MarwanGoat/DIY-3D-PRINTER-/schematics and blueprints/6 - BTT SKR Controller + FSYTEC 12864 RGB LCD.png

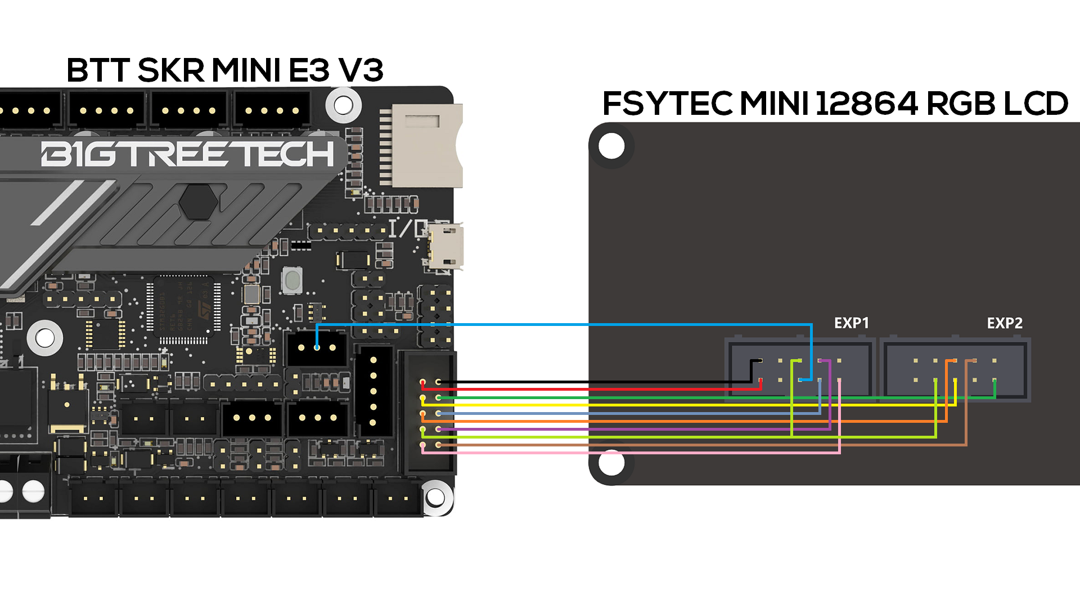
schematics and blueprints/6 - BTT SKR Controller + FSYTEC 12864 RGB LCD.png
