MarwanGoat/DIY-3D-PRINTER-/3d parts ready to print/Hotend Assembly Cover.STL

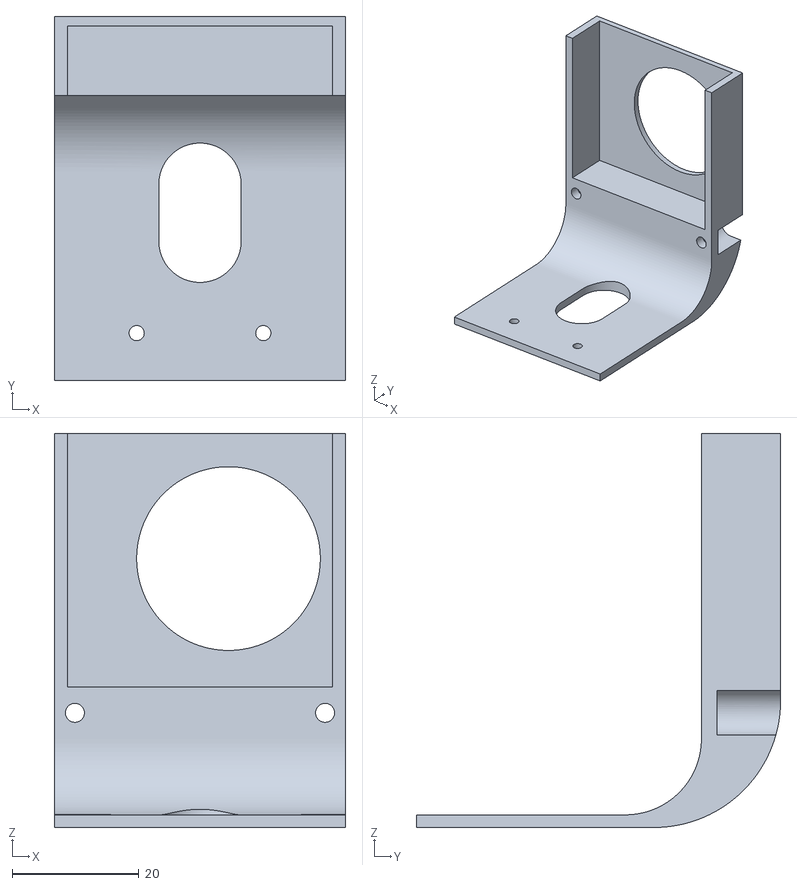
[picture p5: CAD file, 2025-12-25]
3d parts ready to print/Hotend Assembly Cover.STL
46.0 x 57.5 x 62.2
