MarwanGoat/DIY-3D-PRINTER-/3d parts ready to print/Hotend Assembly (For E3D V6).STL

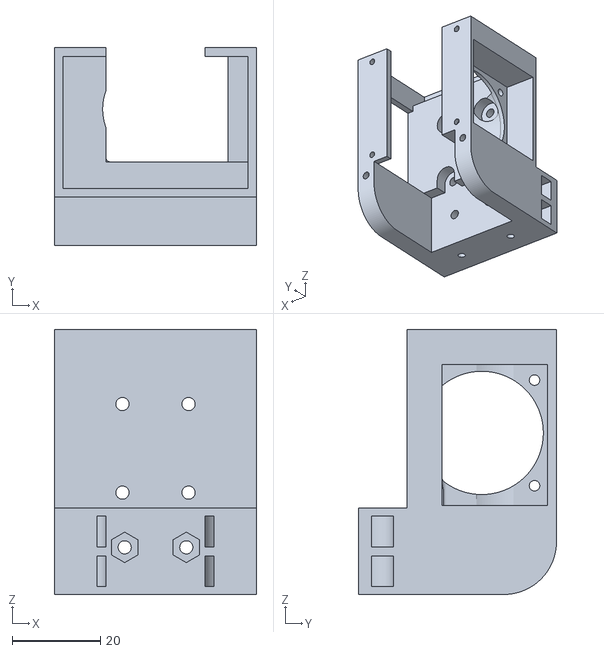
[picture p6: CAD file, 2025-12-25]
3d parts ready to print/Hotend Assembly (For E3D V6).STL
46.0 x 45.0 x 60.2
