MarwanGoat/DIY-3D-PRINTER-/3d parts ready to print/Filament Rear Bar Bracket (1x1 Tubular).STL

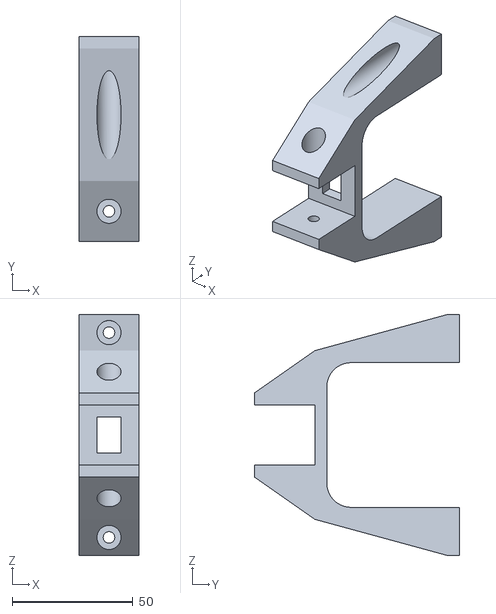
[picture p7: CAD file, 2025-12-25]
3d parts ready to print/Filament Rear Bar Bracket (1x1 Tubular).STL
25.0 x 85.0 x 100.0
