MarwanGoat/DIY-3D-PRINTER-/3d parts ready to print/Stepper Bracket (Bowden Extruder).STL

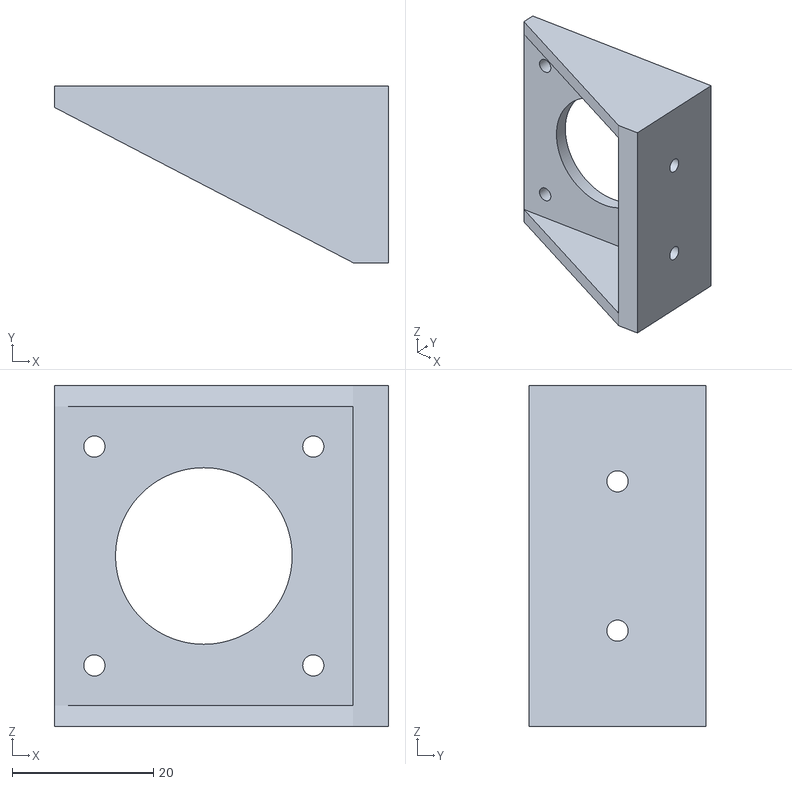
[picture p8: CAD file, 2025-12-25]
3d parts ready to print/Stepper Bracket (Bowden Extruder).STL
47.3 x 25.0 x 48.3
