MarwanGoat/DIY-3D-PRINTER-/3d parts ready to print/Hotend Fan Duct (4010 Fan).STL

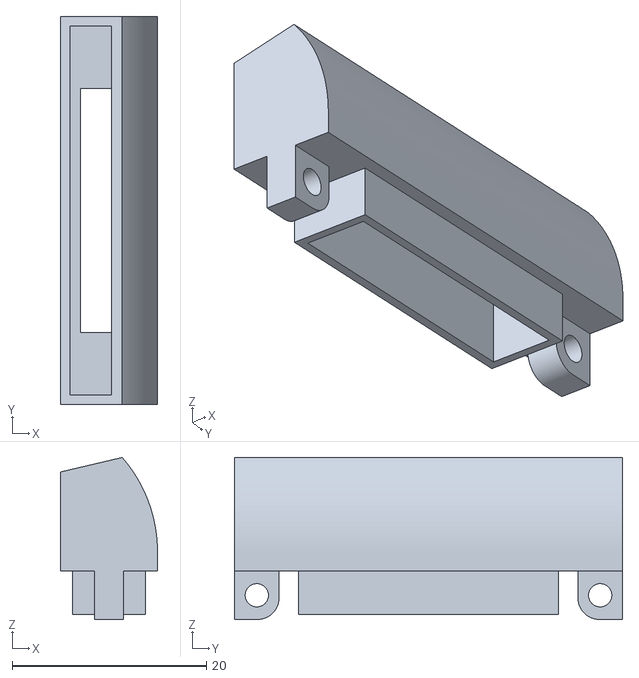
[picture p9: CAD file, 2025-12-25]
3d parts ready to print/Hotend Fan Duct (4010 Fan).STL
10.0 x 40.0 x 16.7
