MarwanGoat/DIY-3D-PRINTER-/3d parts ready to print/Belt Fastener Clips.STL

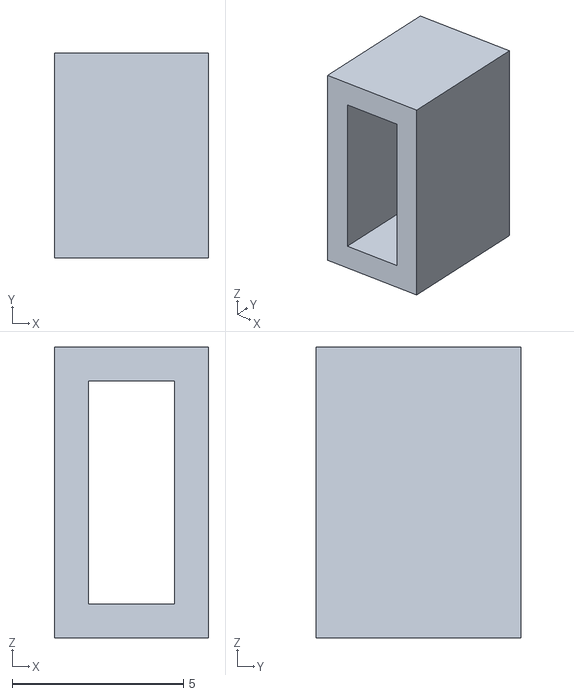
[picture p10: CAD file, 2025-12-25]
3d parts ready to print/Belt Fastener Clips.STL
4.50 x 6.00 x 8.50
