MarwanGoat/DIY-3D-PRINTER-/3d parts ready to print/LCD Bracket (12864 FYSTEC).STL

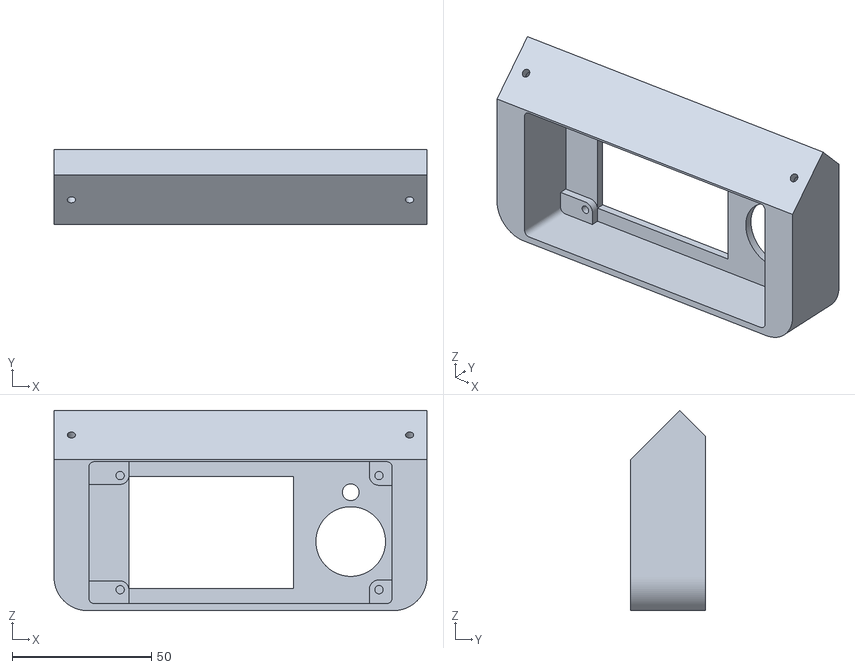
[picture p11: CAD file, 2025-12-25]
3d parts ready to print/LCD Bracket (12864 FYSTEC).STL
134.0 x 26.9 x 71.9
