MarwanGoat/DIY-3D-PRINTER-/3d parts ready to print/Stepper Bracket (Right).STL

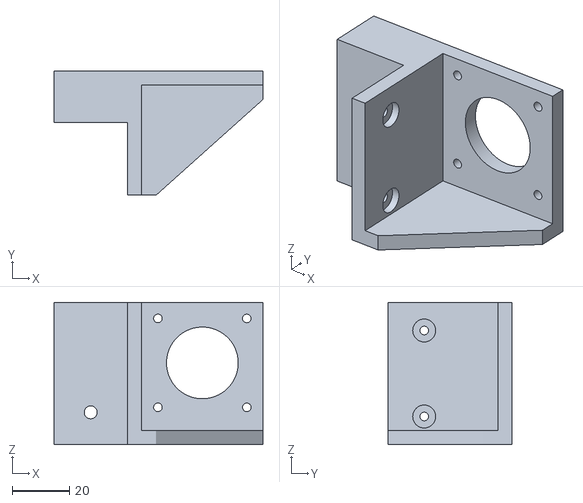
[picture p12: CAD file, 2025-12-25]
3d parts ready to print/Stepper Bracket (Right).STL
72.9 x 43.4 x 49.7
