MarwanGoat/DIY-3D-PRINTER-/3d parts ready to print/Endstop Bracket (Y-Axis).STL

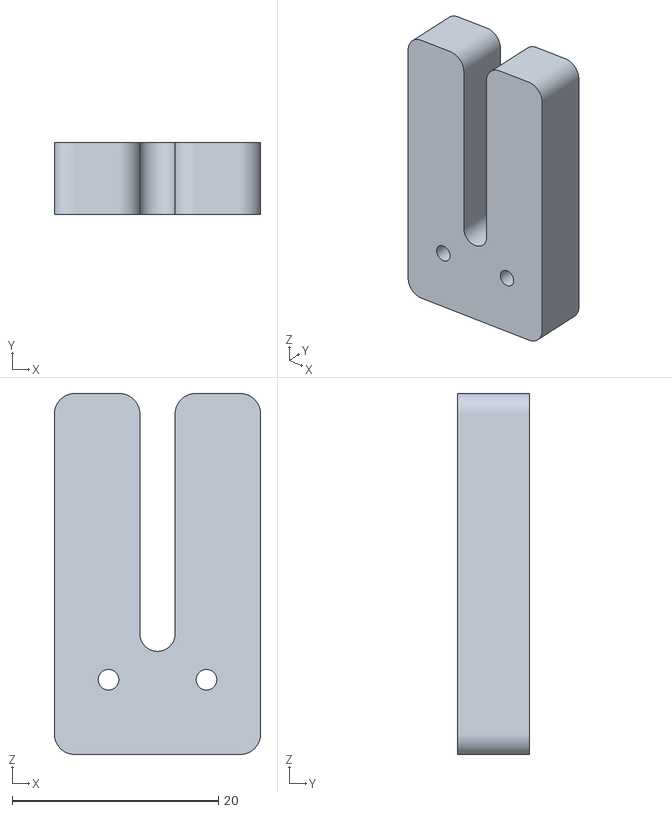
[picture p13: CAD file, 2025-12-25]
3d parts ready to print/Endstop Bracket (Y-Axis).STL
20.0 x 7.00 x 35.0
