MarwanGoat/DIY-3D-PRINTER-/3d parts ready to print/Filament Front Bar Bracket (1x1 Tubular).STL

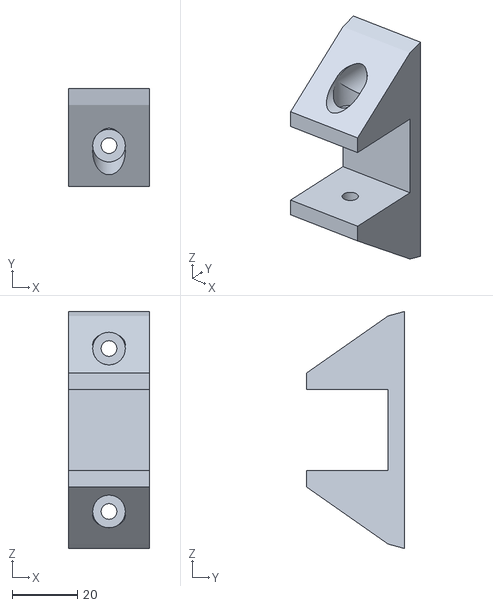
[picture p14: CAD file, 2025-12-25]
3d parts ready to print/Filament Front Bar Bracket (1x1 Tubular).STL
25.0 x 30.0 x 72.7
