MarwanGoat/DIY-3D-PRINTER-/3d parts ready to print/XY Brackets (L&R).STL

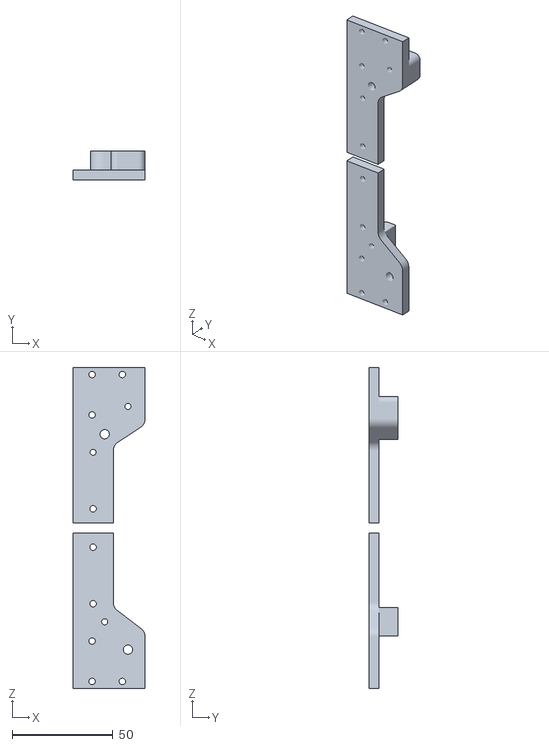
[picture p15: CAD file, 2025-12-25]
3d parts ready to print/XY Brackets (L&R).STL
35.8 x 14.3 x 159.0
