MarwanGoat/DIY-3D-PRINTER-/3d parts ready to print/PSU Shroud.STL

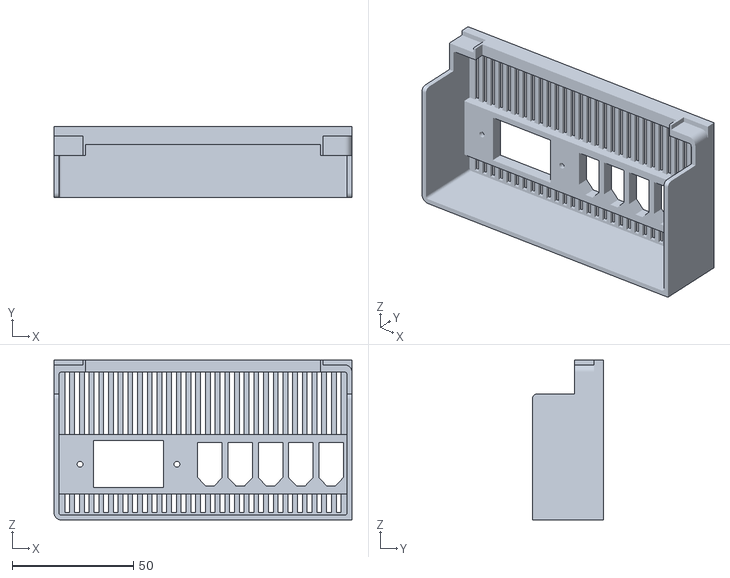
[picture p16: CAD file, 2025-12-25]
3d parts ready to print/PSU Shroud.STL
123.0 x 29.5 x 66.0
