MarwanGoat/DIY-3D-PRINTER-/3d parts ready to print/Magnetic Webcam Mount.STL

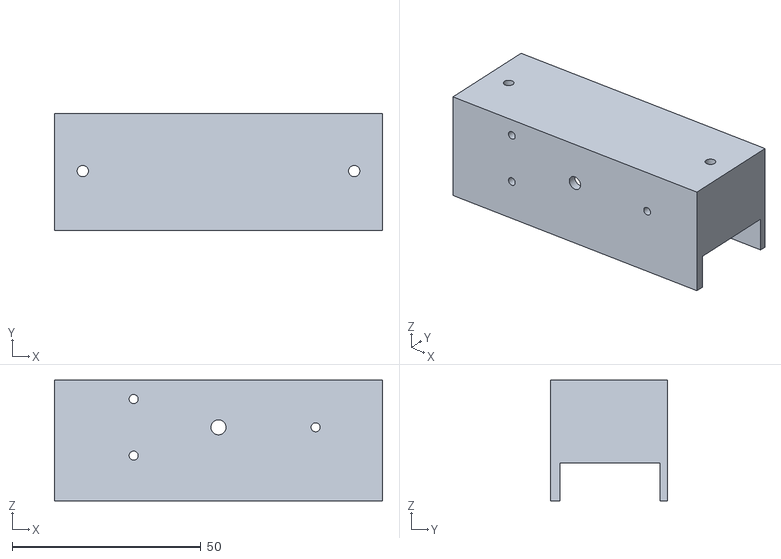
[picture p17: CAD file, 2025-12-25]
3d parts ready to print/Magnetic Webcam Mount.STL
87.0 x 31.1 x 32.0
