MarwanGoat/DIY-3D-PRINTER-/3d parts ready to print/Front Pulley (Left).STL

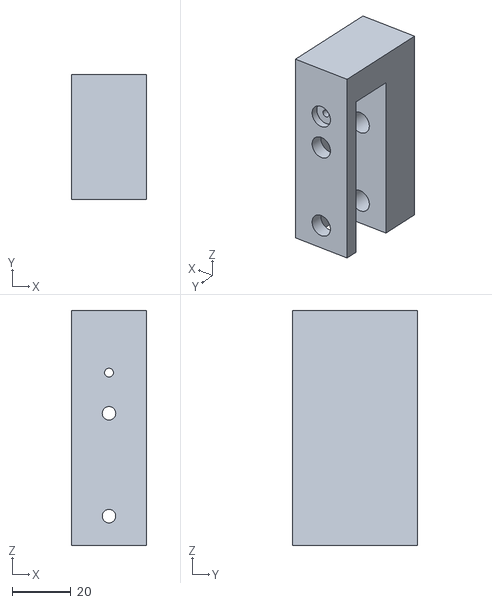
[picture p18: CAD file, 2025-12-25]
3d parts ready to print/Front Pulley (Left).STL
25.4 x 42.5 x 80.0
