MarwanGoat/DIY-3D-PRINTER-/3d parts ready to print/Hotend Grill V2.STL

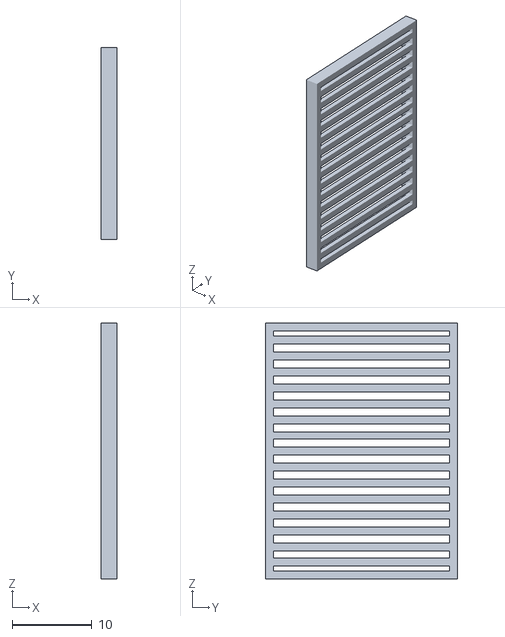
[picture p19: CAD file, 2025-12-25]
3d parts ready to print/Hotend Grill V2.STL
2.00 x 24.0 x 32.0
