MarwanGoat/DIY-3D-PRINTER-/3d parts ready to print/USB Port & XT60 Hub.STL

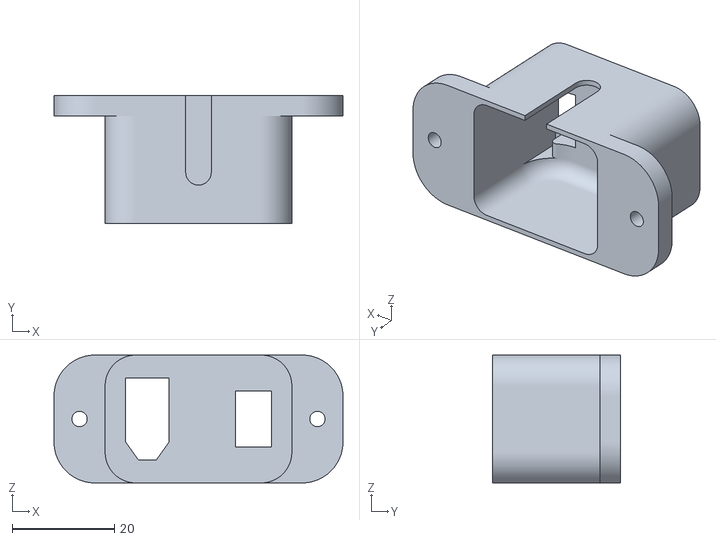
[picture p20: CAD file, 2025-12-25]
3d parts ready to print/USB Port & XT60 Hub.STL
56.5 x 25.0 x 25.0
