MarwanGoat/DIY-3D-PRINTER-/3d parts ready to print/Filament Spool Shaft.STL

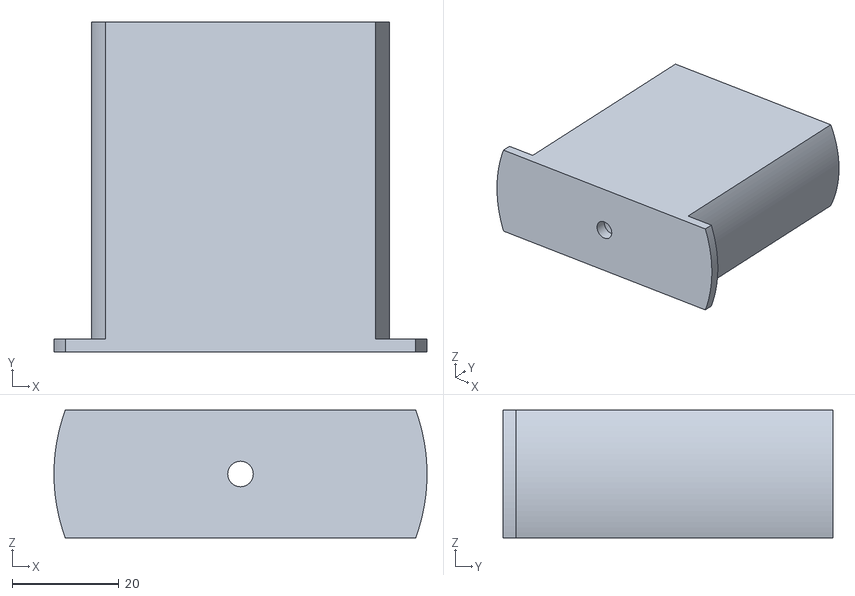
[picture p21: CAD file, 2025-12-25]
3d parts ready to print/Filament Spool Shaft.STL
70.0 x 62.0 x 24.0
