MarwanGoat/DIY-3D-PRINTER-/3d parts ready to print/Endstop Bumper (X-axis).STL

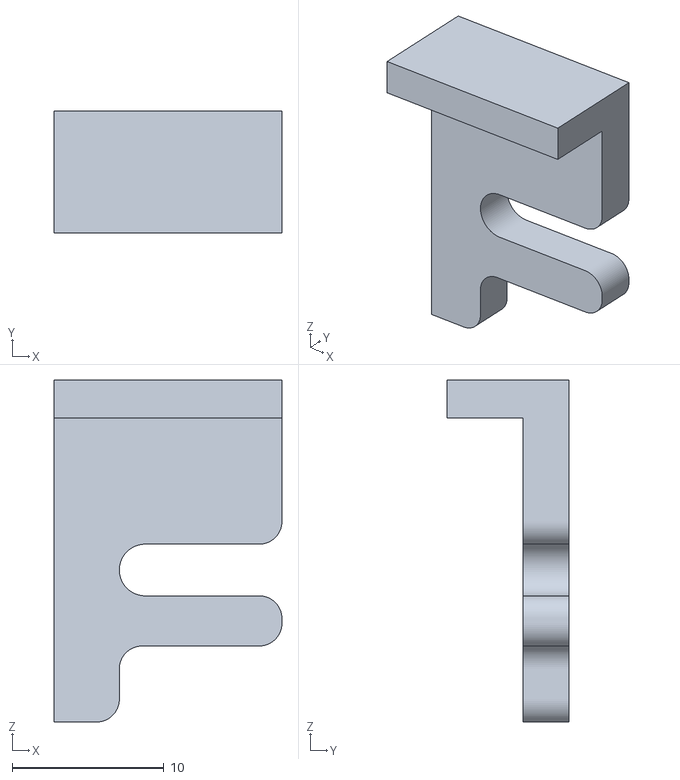
[picture p22: CAD file, 2025-12-25]
3d parts ready to print/Endstop Bumper (X-axis).STL
15.0 x 8.00 x 22.5
